kostyamat/Radio-remote-control-for-car-radios/(commit log)

2019-12-11 Add files via upload
    Как пример. Модуль руля с псевдокнопками KIA Magentis II переделанный в модуль кнопок управления магнитолой.
2020-02-18 Add files via upload
    Несколько переработан способ ухода в сон.
    Учтены дополнительные способы снижения энергопотребления.
    Добавлена звуковая индикация, даже если буззер дезактивирован, в случае пяти, и больше, неудачных сеансов передачи данных передатчиком.
    Поправлено чтение входа "подсветка", теперь он должен оперативно реагировать на изменение своего состояния и будить передатчик, д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
